Kyrylo-Nazarevych/quad-branch-predictor/verification/expected/pattern_alternating_O0/predictions.csv

index | pc8 | taken | perceptron | bimodal | gshare | tournament | cycles
0 | 228 | 1 | 1 | 1 | 1 | 1
1 | 176 | 1 | 1 | 1 | 1 | 1
2 | 228 | 1 | 0 | 1 | 1 | 1
3 | 176 | 0 | 1 | 1 | 1 | 1
4 | 228 | 1 | 0 | 1 | 1 | 1
5 | 176 | 1 | 0 | 1 | 1 | 1
6 | 228 | 1 | 0 | 1 | 1 | 1
7 | 176 | 0 | 0 | 1 | 1 | 1
8 | 228 | 1 | 0 | 1 | 1 | 1
9 | 176 | 1 | 0 | 1 | 1 | 1
10 | 228 | 1 | 1 | 1 | 1 | 1
11 | 176 | 0 | 0 | 1 | 0 | 1
12 | 228 | 1 | 1 | 1 | 1 | 1
13 | 176 | 1 | 1 | 1 | 1 | 1
14 | 228 | 1 | 1 | 1 | 1 | 1
15 | 176 | 0 | 0 | 1 | 0 | 0
16 | 228 | 1 | 1 | 1 | 1 | 1
17 | 176 | 1 | 1 | 1 | 1 | 1
18 | 228 | 1 | 1 | 1 | 1 | 1
19 | 176 | 0 | 0 | 1 | 0 | 0
20 | 228 | 1 | 1 | 1 | 1 | 1
21 | 176 | 1 | 1 | 1 | 1 | 1
22 | 228 | 1 | 1 | 1 | 1 | 1
23 | 176 | 0 | 0 | 1 | 0 | 0
24 | 228 | 1 | 1 | 1 | 1 | 1
25 | 176 | 1 | 1 | 1 | 1 | 1
26 | 228 | 1 | 1 | 1 | 1 | 1
27 | 176 | 0 | 0 | 1 | 0 | 0
28 | 228 | 1 | 1 | 1 | 1 | 1
29 | 176 | 1 | 1 | 1 | 1 | 1
30 | 228 | 1 | 1 | 1 | 1 | 1
31 | 176 | 0 | 0 | 1 | 0 | 0
32 | 228 | 1 | 1 | 1 | 1 | 1
33 | 176 | 1 | 1 | 1 | 1 | 1
34 | 228 | 1 | 1 | 1 | 1 | 1
35 | 176 | 0 | 0 | 1 | 0 | 0
36 | 228 | 1 | 1 | 1 | 1 | 1
37 | 176 | 1 | 1 | 1 | 1 | 1
38 | 228 | 1 | 1 | 1 | 1 | 1
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
