Kyrylo-Nazarevych/quad-branch-predictor/verification/expected/pattern_loop4_O0/predictions.csv

index | pc8 | taken | perceptron | bimodal | gshare | tournament | cycles
0 | 240 | 1 | 1 | 1 | 1 | 1
1 | 216 | 1 | 1 | 1 | 1 | 1
2 | 216 | 1 | 1 | 1 | 1 | 1
3 | 216 | 1 | 1 | 1 | 1 | 1
4 | 216 | 1 | 1 | 1 | 1 | 1
5 | 216 | 0 | 1 | 1 | 1 | 1
6 | 240 | 1 | 0 | 1 | 1 | 1
7 | 216 | 1 | 0 | 1 | 1 | 1
8 | 216 | 1 | 0 | 1 | 1 | 1
9 | 216 | 1 | 1 | 1 | 1 | 1
10 | 216 | 1 | 1 | 1 | 1 | 1
11 | 216 | 0 | 1 | 1 | 1 | 1
12 | 240 | 1 | 1 | 1 | 1 | 1
13 | 216 | 1 | 1 | 1 | 1 | 1
14 | 216 | 1 | 1 | 1 | 1 | 1
15 | 216 | 1 | 1 | 1 | 1 | 1
16 | 216 | 1 | 1 | 1 | 1 | 1
17 | 216 | 0 | 1 | 1 | 0 | 1
18 | 240 | 1 | 1 | 1 | 1 | 1
19 | 216 | 1 | 1 | 1 | 1 | 1
20 | 216 | 1 | 1 | 1 | 1 | 1
21 | 216 | 1 | 1 | 1 | 1 | 1
22 | 216 | 1 | 1 | 1 | 1 | 1
23 | 216 | 0 | 1 | 1 | 0 | 0
24 | 240 | 1 | 1 | 1 | 1 | 1
25 | 216 | 1 | 1 | 1 | 1 | 1
26 | 216 | 1 | 1 | 1 | 1 | 1
27 | 216 | 1 | 1 | 1 | 1 | 1
28 | 216 | 1 | 1 | 1 | 1 | 1
29 | 216 | 0 | 1 | 1 | 0 | 0
30 | 240 | 1 | 1 | 1 | 1 | 1
31 | 216 | 1 | 1 | 1 | 1 | 1
32 | 216 | 1 | 1 | 1 | 1 | 1
33 | 216 | 1 | 1 | 1 | 1 | 1
34 | 216 | 1 | 1 | 1 | 1 | 1
35 | 216 | 0 | 1 | 1 | 0 | 0
36 | 240 | 1 | 1 | 1 | 1 | 1
37 | 216 | 1 | 1 | 1 | 1 | 1
38 | 216 | 1 | 1 | 1 | 1 | 1
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
