Kyrylo-Nazarevych/quad-branch-predictor/verification/expected/pattern_xor_O0/predictions.csv

index | pc8 | taken | perceptron | bimodal | gshare | tournament | cycles
0 | 172 | 1 | 1 | 1 | 1 | 1
1 | 88 | 1 | 1 | 1 | 1 | 1
2 | 108 | 0 | 0 | 1 | 1 | 1
3 | 132 | 0 | 1 | 1 | 1 | 1
4 | 172 | 1 | 1 | 1 | 0 | 1
5 | 88 | 0 | 1 | 1 | 1 | 1
6 | 108 | 0 | 0 | 0 | 1 | 0
7 | 132 | 1 | 1 | 0 | 1 | 0
8 | 172 | 1 | 1 | 1 | 1 | 1
9 | 88 | 1 | 0 | 1 | 1 | 1
10 | 108 | 1 | 0 | 0 | 1 | 0
11 | 132 | 1 | 1 | 1 | 1 | 1
12 | 172 | 1 | 0 | 1 | 1 | 1
13 | 88 | 1 | 0 | 1 | 0 | 1
14 | 108 | 0 | 1 | 0 | 1 | 0
15 | 132 | 0 | 1 | 1 | 1 | 1
16 | 172 | 1 | 0 | 1 | 1 | 1
17 | 88 | 0 | 1 | 1 | 1 | 1
18 | 108 | 0 | 0 | 0 | 1 | 0
19 | 132 | 1 | 1 | 1 | 1 | 1
20 | 172 | 1 | 1 | 1 | 1 | 1
21 | 88 | 1 | 1 | 1 | 1 | 1
22 | 108 | 0 | 0 | 0 | 1 | 0
23 | 132 | 0 | 1 | 1 | 1 | 1
24 | 172 | 1 | 1 | 1 | 1 | 1
25 | 88 | 1 | 0 | 1 | 1 | 1
26 | 108 | 1 | 0 | 0 | 1 | 0
27 | 132 | 1 | 1 | 1 | 1 | 1
28 | 172 | 1 | 1 | 1 | 1 | 1
29 | 88 | 1 | 1 | 1 | 1 | 1
30 | 108 | 1 | 0 | 0 | 1 | 0
31 | 132 | 1 | 1 | 1 | 1 | 1
32 | 172 | 1 | 1 | 1 | 1 | 1
33 | 88 | 1 | 1 | 1 | 0 | 1
34 | 108 | 1 | 1 | 1 | 1 | 1
35 | 132 | 1 | 1 | 1 | 1 | 1
36 | 172 | 1 | 1 | 1 | 1 | 1
37 | 88 | 1 | 1 | 1 | 1 | 1
38 | 108 | 1 | 1 | 1 | 1 | 1
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
