Kyrylo-Nazarevych/quad-branch-predictor/verification/expected/ref704_committed_log/predictions.csv

index | pc8 | taken | perceptron | bimodal | gshare | tournament | cycles
0 | 76 | 1 | 1 | 1 | 1 | 1
1 | 148 | 1 | 1 | 1 | 1 | 1
2 | 88 | 1 | 1 | 1 | 1 | 1
3 | 112 | 0 | 1 | 1 | 1 | 1
4 | 148 | 1 | 0 | 1 | 1 | 1
5 | 88 | 1 | 0 | 1 | 1 | 1
6 | 112 | 1 | 1 | 0 | 1 | 0
7 | 148 | 1 | 0 | 1 | 1 | 1
8 | 88 | 1 | 1 | 1 | 1 | 1
9 | 112 | 1 | 1 | 1 | 1 | 1
10 | 148 | 1 | 1 | 1 | 1 | 1
11 | 88 | 0 | 1 | 1 | 1 | 1
12 | 112 | 1 | 1 | 1 | 1 | 1
13 | 148 | 1 | 1 | 1 | 0 | 1
14 | 88 | 0 | 0 | 1 | 1 | 1
15 | 112 | 0 | 1 | 1 | 1 | 1
16 | 148 | 1 | 1 | 1 | 1 | 1
17 | 88 | 0 | 0 | 0 | 1 | 0
18 | 112 | 1 | 1 | 1 | 1 | 1
19 | 148 | 1 | 1 | 1 | 1 | 1
20 | 88 | 0 | 0 | 0 | 1 | 0
21 | 112 | 1 | 1 | 1 | 1 | 1
22 | 148 | 1 | 1 | 1 | 1 | 1
23 | 88 | 0 | 0 | 0 | 0 | 0
24 | 112 | 1 | 1 | 1 | 0 | 0
25 | 148 | 1 | 1 | 1 | 1 | 1
26 | 88 | 0 | 0 | 0 | 1 | 0
27 | 112 | 0 | 1 | 1 | 1 | 1
28 | 148 | 1 | 1 | 1 | 1 | 1
29 | 88 | 0 | 0 | 0 | 0 | 0
30 | 112 | 1 | 1 | 1 | 1 | 1
31 | 148 | 1 | 1 | 1 | 1 | 1
32 | 88 | 0 | 0 | 0 | 0 | 0
33 | 112 | 1 | 1 | 1 | 1 | 1
34 | 148 | 1 | 1 | 1 | 1 | 1
35 | 88 | 0 | 0 | 0 | 0 | 0
36 | 112 | 1 | 1 | 1 | 0 | 1
37 | 148 | 1 | 1 | 1 | 1 | 1
38 | 88 | 0 | 0 | 0 | 0 | 0
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
