Kyrylo-Nazarevych/quad-branch-predictor/verification/expected/sort_and_search_O1/predictions.csv

index | pc8 | taken | perceptron | bimodal | gshare | tournament | cycles
0 | 136 | 1 | 1 | 1 | 1 | 1
1 | 136 | 1 | 1 | 1 | 1 | 1
2 | 136 | 1 | 1 | 1 | 1 | 1
3 | 136 | 1 | 1 | 1 | 1 | 1
4 | 136 | 1 | 1 | 1 | 1 | 1
5 | 136 | 1 | 1 | 1 | 1 | 1
6 | 136 | 1 | 1 | 1 | 1 | 1
7 | 136 | 1 | 1 | 1 | 1 | 1
8 | 136 | 1 | 1 | 1 | 1 | 1
9 | 136 | 1 | 1 | 1 | 1 | 1
10 | 136 | 1 | 1 | 1 | 1 | 1
11 | 136 | 1 | 1 | 1 | 1 | 1
12 | 136 | 1 | 1 | 1 | 1 | 1
13 | 136 | 1 | 1 | 1 | 1 | 1
14 | 136 | 1 | 1 | 1 | 1 | 1
15 | 136 | 1 | 1 | 1 | 1 | 1
16 | 136 | 1 | 1 | 1 | 1 | 1
17 | 136 | 1 | 1 | 1 | 1 | 1
18 | 136 | 1 | 1 | 1 | 1 | 1
19 | 136 | 1 | 1 | 1 | 1 | 1
20 | 136 | 1 | 1 | 1 | 1 | 1
21 | 136 | 1 | 1 | 1 | 1 | 1
22 | 136 | 1 | 1 | 1 | 1 | 1
23 | 136 | 1 | 1 | 1 | 1 | 1
24 | 136 | 1 | 1 | 1 | 1 | 1
25 | 136 | 1 | 1 | 1 | 1 | 1
26 | 136 | 1 | 1 | 1 | 1 | 1
27 | 136 | 1 | 1 | 1 | 1 | 1
28 | 136 | 1 | 1 | 1 | 1 | 1
29 | 136 | 1 | 1 | 1 | 1 | 1
30 | 136 | 1 | 1 | 1 | 1 | 1
31 | 136 | 1 | 1 | 1 | 1 | 1
32 | 136 | 1 | 1 | 1 | 1 | 1
33 | 136 | 1 | 1 | 1 | 1 | 1
34 | 136 | 1 | 1 | 1 | 1 | 1
35 | 136 | 1 | 1 | 1 | 1 | 1
36 | 136 | 1 | 1 | 1 | 1 | 1
37 | 136 | 1 | 1 | 1 | 1 | 1
38 | 136 | 1 | 1 | 1 | 1 | 1
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
