Kyrylo-Nazarevych/quad-branch-predictor/verification/traces/pattern_alternating_O0/branches.csv

pc | count | taken | taken_rate | transition_rate | function | line | mnemonic
800002e4 | 2001 | 2000 | 0.9995 | 0.0005 | main | pattern_alternating.c:6 | bge
800002b0 | 2000 | 1000 | 0.5 | 1.0 | main | pattern_alternating.c:7 | beq
