Kyrylo-Nazarevych/quad-branch-predictor/verification/traces/pattern_loop4_O0/branches.csv

pc | count | taken | taken_rate | transition_rate | function | line | mnemonic
800002d8 | 5000 | 4000 | 0.8 | 0.3999 | main | pattern_loop4.c:7 | bge
800002f0 | 1001 | 1000 | 0.999 | 0.001 | main | pattern_loop4.c:6 | bge
