Kyrylo-Nazarevych/quad-branch-predictor/verification/traces/sort_and_search_O1/branches.csv

pc | count | taken | taken_rate | transition_rate | function | line | mnemonic
800001a4 | 19624 | 9698 | 0.4942 | 0.3535 | bubble_sort | sort_and_search.c:11 | bge
80000198 | 19624 | 176 | 0.009 | 0.0179 | bubble_sort | sort_and_search.c:10 | beq
80000220 | 2251 | 65 | 0.0289 | 0.0573 | binary_search | sort_and_search.c:19 | beq
80000224 | 2186 | 1056 | 0.4831 | 0.5089 | binary_search | sort_and_search.c:20 | bge
80000200 | 2186 | 235 | 0.1075 | 0.2151 | binary_search | sort_and_search.c:17 | blt
80000240 | 300 | 1 | 0.0033 | 0.0033 | main | sort_and_search.c:28 | beq
80000188 | 200 | 199 | 0.995 | 0.005 | main | sort_and_search.c:25 | bne
80000270 | 200 | 199 | 0.995 | 0.005 | main | sort_and_search.c:30 | bne
800001b8 | 176 | 1 | 0.0057 | 0.0057 | bubble_sort | sort_and_search.c:12 | beq
800001c0 | 175 | 0 | 0.0 | 0.0 | bubble_sort | sort_and_search.c:8 | beq
