Kyrylo-Nazarevych/quad-branch-predictor/rtl/perceptron_704.v

/*
 * Copyright (c) 2024 Tristan Robitaille
 * SPDX-License-Identifier: Apache-2.0
 */

`default_nettype none

module bp_perceptron_704 #(
    parameter NUM_BITS_OF_INST_ADDR_LATCHED_IN = 8,
    parameter HISTORY_LENGTH = 7, // Must be a power of 2 - 1 (so we can bit shift, else need to see how large a multiplier would be)
    parameter BIT_WIDTH_WEIGHTS = 8, // Must be 2, 4 or 8
    parameter STORAGE_B = 64, // If larger than 2^7, will need to modify memory since max. address is 7 bits
    parameter MEM_ADDR_WIDTH = $clog2(STORAGE_B),
    parameter STORAGE_PER_PERCEPTRON = ((HISTORY_LENGTH + 1) * BIT_WIDTH_WEIGHTS),
    parameter NUM_PERCEPTRONS = (8 * STORAGE_B / STORAGE_PER_PERCEPTRON),
    parameter PERCEPTRON_INDEX_WIDTH = $clog2(NUM_PERCEPTRONS), // Must be wide enough to store NUM_PERCEPTRONS
    parameter SUM_WIDTH = $clog2(HISTORY_LENGTH * (1 << (BIT_WIDTH_WEIGHTS-1))),
    parameter TRAINING_THRESHOLD = 15
)(
    input  wire [7:0] ui_in,    // Dedicated inputs
    output wire [7:0] uo_out,   // Dedicated outputs
    input  wire [7:0] uio_in,   // IOs: Input path
    output wire [7:0] uio_out,  // IOs: Output path
    output wire [7:0] uio_oe,   // IOs: Enable path (active high: 0=input, 1=output)
    input  wire       ena,      // always 1 when the design is powered, so you can ignore it
    input  wire       clk,      // clock
    input  wire       rst_n     // reset_n - low to reset
);

    //---------------------------------
    //          DECLARATIONS
    //---------------------------------
    // Declared before first use (the pin assignments below), so every simulator accepts the file.
    wire new_data_avail, new_data_avail_posedge;
    wire history_buffer_request; // continuous assignment below (wire, not reg, for Verilog-2005 simulators)
    wire direction_ground_truth;
    wire [NUM_BITS_OF_INST_ADDR_LATCHED_IN-1:0] inst_addr;
    reg new_data_avail_prev;
    reg wr_en; // 0: Read, 1: Write
    reg prediction, pred_ready, training_done;
    reg state_rst_memory, mem_reset_done;
    reg [1:0] state_pred;
    reg [7:0] mem_data_in;
    wire [7:0] mem_data_out; // driven by the latch RAM output port (wire, not reg, for Verilog-2005 simulators)
    reg [$clog2(HISTORY_LENGTH+1+1)-1:0] cnt;
    reg [SUM_WIDTH-1:0] sum;
    reg [PERCEPTRON_INDEX_WIDTH-1:0] perceptron_index;
    reg [HISTORY_LENGTH:0] history_buffer;
    reg [MEM_ADDR_WIDTH-1:0] mem_addr;
    reg history_buffer_empty_state, history_buffer_output;
    reg history_buffer_request_prev;
    reg [$clog2(HISTORY_LENGTH+1)-1:0] history_buffer_index;

    //---------------------------------
    //              PINS
    //---------------------------------
    // All output pins must be assigned. If not used, assign to 0.
    assign uio_out[PERCEPTRON_INDEX_WIDTH-1+2:2] = perceptron_index; // Debug
    assign uio_out[1:0] = 'h0;
    assign uio_out[PERCEPTRON_INDEX_WIDTH+2] = wr_en; // Debug
    assign uio_out[PERCEPTRON_INDEX_WIDTH+2+1] = history_buffer_output; // Input
    assign uio_out[7:PERCEPTRON_INDEX_WIDTH+2+2] = 'b0; // Input

    assign uio_oe[0] = 1'b0; // new_data_avail
    assign uio_oe[1] = 1'b0; // direction_ground_truth
    assign uio_oe[PERCEPTRON_INDEX_WIDTH-1+2:2] = 'hFFF; // Output perceptron index
    assign uio_oe[PERCEPTRON_INDEX_WIDTH+2] = 'hFFF; // Output wr_en
    assign uio_oe[PERCEPTRON_INDEX_WIDTH+2+1] = 1'b1; // History buffer output (was [7:6], which also drove bit 7)
    assign uio_oe[7:PERCEPTRON_INDEX_WIDTH+2+2] = 'h0; // History buffer request

    assign uo_out[0] = pred_ready;
    assign uo_out[1] = prediction;
    assign uo_out[2] = training_done;
    assign uo_out[3] = mem_reset_done;
    assign uo_out[4] = new_data_avail_posedge; // Debug
    assign uo_out[6:5] = state_pred; // Debug
    assign uo_out[7] = state_rst_memory; // Debug

    // List all unused inputs to prevent warnings
    wire [7:0] uio_oe_mem_unused, uio_out_unused;
    wire _unused = &{ena, clk, rst_n, uio_oe_mem_unused, uio_out_unused, 1'b0, uio_in[7:2], inst_addr[1:0], inst_addr[7:7-PERCEPTRON_INDEX_WIDTH+2]};


    assign new_data_avail = uio_in[0];
    assign direction_ground_truth = uio_in[1];
    assign history_buffer_request = uio_in[7];
    assign new_data_avail_posedge = (new_data_avail & ~new_data_avail_prev);
    assign inst_addr = ui_in;

    always @ (posedge clk) begin
        new_data_avail_prev <= (rst_n) ? new_data_avail : 1'b0;
    end

    //---------------------------------
    //           PREDICTOR
    //---------------------------------
    /*
        The prediction is given by the sign of the sum of the weights multiplied by the history buffer.
        The starting index (byte) of the weights for a perceptron is given by: (HISTORY_LENGTH + 1) * perceptron_index * (BIT_WIDTH_WEIGHTS/8)
    */

    parameter NOT_RESETTING_MEM = 1'd0, RESETTING_MEMORY = 1'd1;
    parameter IDLE = 2'd0, COMPUTING = 2'd1, PRE_TRAINING_DELAY = 2'd2, TRAINING = 2'd3;

    bp_latch_mem #(
        .RAM_BYTES(STORAGE_B)
    ) latch_mem (
        .ui_in({wr_en, {(7-MEM_ADDR_WIDTH){1'b0}}, mem_addr}), // [wr_en|padding|addr]
        .uo_out(mem_data_out), // Data output (8b)
        .uio_in(mem_data_in),  // Data input (8b)
        .ena(ena), .clk(clk), .rst_n(rst_n),
        .uio_out(uio_out_unused), // Unused
        .uio_oe(uio_oe_mem_unused) // Unused
    );

    always @ (*) begin
        perceptron_index = inst_addr[PERCEPTRON_INDEX_WIDTH-1 + 2 : 2]; // Implements (inst_addr >> 2) % NUM_PERCEPTRONS
    end

    always @ (posedge clk) begin
        if (!rst_n) begin
            history_buffer <= 'b0;
        end else begin
            if (training_done) begin
                history_buffer <= {history_buffer[HISTORY_LENGTH-1:0], direction_ground_truth};
            end
        end
    end

    wire [SUM_WIDTH-1:0] mem_data_out_casted = {{(SUM_WIDTH-BIT_WIDTH_WEIGHTS){mem_data_out[BIT_WIDTH_WEIGHTS-1]}}, mem_data_out};
    wire signed [SUM_WIDTH-1:0] abs_sum;
    assign abs_sum = sum[SUM_WIDTH-1] ? (~sum + 1) : sum;

    reg [1:0] substate;

    always @ (posedge clk) begin
        if (!rst_n) begin
            state_pred <= IDLE;
            mem_addr <= 'd0;
            mem_reset_done <= 1'b0;
            wr_en <= 1'b1;
            state_rst_memory <= RESETTING_MEMORY;
            mem_data_in <= 'b0;
            // Defined from reset: training_done also enables the history shift, so an unknown
            // power-up value could shift garbage into history_buffer during the memory reset.
            // cnt, substate and sum are always set before use, but reset them too so the core
            // starts from a known state (gate-level simulation otherwise carries X through them).
            training_done <= 1'b0;
            pred_ready <= 1'b0;
            prediction <= 1'b0;
            cnt <= 'd0;
            substate <= 'd0;
            sum <= 'd0;
        end else begin
            if (state_rst_memory == RESETTING_MEMORY) begin
                mem_addr <= (wr_en) ? mem_addr : (mem_addr + 1);
                wr_en <= ~wr_en;
                if (mem_addr == (STORAGE_B-1)) begin
                    state_rst_memory <= NOT_RESETTING_MEM;
                    mem_reset_done <= 1'b1;
                end
            end else begin
                mem_reset_done <= 1'b0;
                case (state_pred)
                    IDLE: begin
                        substate <= 'd0;
                        wr_en <= 1'b0; // Read
                        training_done <= 1'b0;
                        pred_ready <= 1'b0;
                        cnt <= 'd0;
                        if (new_data_avail_posedge) begin
                            state_pred <= COMPUTING;
                            mem_addr <= ({(8-$clog2(HISTORY_LENGTH + 1)){perceptron_index}} << $clog2(HISTORY_LENGTH + 1)); // Bit shift instead of multiply since (HISTORY_LENGTH + 1) is a power of 2
                        end
                    end
                    COMPUTING: begin
                        cnt <= cnt + 1;
                        if (cnt == 'd0) begin
                            mem_addr <= mem_addr + 1;
                        end else if (cnt == 'd1) begin // Skip 0 because there is a delay getting SRAM data
                            sum <= mem_data_out_casted;
                            mem_addr <= mem_addr + 1;
                        end else if (cnt < HISTORY_LENGTH+2) begin
                            sum <= (history_buffer[cnt-2]) ? (sum + mem_data_out_casted) : sum; // If taken, add the weight
                            mem_addr <= mem_addr + 1;
                        end else begin
                            if ((~sum[SUM_WIDTH-1] != direction_ground_truth) | (abs_sum <= TRAINING_THRESHOLD)) begin
                                state_pred <= PRE_TRAINING_DELAY;
                                mem_addr <= ({(8-$clog2(HISTORY_LENGTH + 1)){perceptron_index}} << $clog2(HISTORY_LENGTH + 1)); // Bit shift instead of multiply since (HISTORY_LENGTH + 1) is a power of 2
                            end else begin
                                state_pred <= IDLE;
                                training_done <= 1'b1;
                            end
                            prediction <= ~sum[SUM_WIDTH-1]; // Equivalent to (sum >= 0)
                            pred_ready <= 1'b1;
                            cnt <= 'd0;
                        end
                    end
                    PRE_TRAINING_DELAY: begin
                        state_pred <= TRAINING;
                        pred_ready <= 1'b0;
                    end
                    TRAINING: begin
                        if (substate == 0) begin // Write
                            if (cnt == 'd0) begin
                                mem_data_in <= (direction_ground_truth) ? (mem_data_out + 1) : (mem_data_out - 1);
                                substate <= 1;
                                wr_en <= 1'b1;
                            end else if (cnt < HISTORY_LENGTH+1) begin
                                mem_data_in <= (history_buffer[cnt-1] == direction_ground_truth) ? (mem_data_out + 1) : (mem_data_out - 1); // If agreement, increment the weight, else decrement
                                substate <= 1;
                                wr_en <= 1'b1;
                            end else begin
                                state_pred <= IDLE;
                                training_done <= 1'b1;
                            end
                        end else if (substate == 1) begin
                            substate <= 2;
                        end else if (substate == 2) begin // Read
                            wr_en <= 1'b0;
                            mem_addr <= mem_addr + 1;
                            cnt <= cnt + 1;
                            substate <= 3;
                        end else if (substate == 3) begin
                            substate <= 0;
                        end
                    end
                    default:
                        state_pred <= IDLE;
                endcase
            end
        end
    end

    //---------------------------------
    //           HISTORY
    //---------------------------------
    /*
        Can request the history buffer to be outputted to the IOs. Useful for debugging.
    */
    localparam HISTORY_BUFFER_NOT_OUTPUTTING = 1'b0, HISTORY_BUFFER_OUTPUTTING = 1'b1;

    wire history_buffer_request_posedge;
    assign history_buffer_request_posedge = (history_buffer_request & ~history_buffer_request_prev);

    always @ (posedge clk) begin
        history_buffer_request_prev <= history_buffer_request;
        if (!rst_n) begin
            history_buffer_empty_state <= 1'b0;
            history_buffer_index <= HISTORY_BUFFER_NOT_OUTPUTTING;
            history_buffer_output <= 1'b0;
        end else begin
            case (history_buffer_empty_state)
                HISTORY_BUFFER_NOT_OUTPUTTING: begin
                    history_buffer_index <= 'd0;
                    if (history_buffer_request_posedge) begin
                        history_buffer_empty_state <= HISTORY_BUFFER_OUTPUTTING;
                        history_buffer_output <= history_buffer[0];
                    end else begin
                        history_buffer_output <= 'b0;
                    end
                end
                HISTORY_BUFFER_OUTPUTTING: begin
                    history_buffer_index <= history_buffer_index + 1;
                    history_buffer_empty_state <= (history_buffer_index == HISTORY_LENGTH-1) ? HISTORY_BUFFER_NOT_OUTPUTTING : HISTORY_BUFFER_OUTPUTTING;
                    history_buffer_output <= history_buffer[history_buffer_index+1];
                end
                default:
                    history_buffer_empty_state <= HISTORY_BUFFER_NOT_OUTPUTTING;
            endcase
        end
    end


endmodule
